tbourgoi/Projet-PeiP-2/programmes/programmes années précédentes.odt

Programmes années précédentes

Programmes DI38 Yoyotte Carla Pierre Rocheteau

1. Programme permettant au robot d'avancer :

/* Programme Avance*/ /* Faire fonctionner les moteurs */

#include<Servo.h>

#define SERVO_GAUCHE_PIN 10

#define SERVO_DROIT_PIN 11

#define T1_1 1700//durée T1 sens horaire

#define T1_2 1300//durée T1 sens trigonométrique

#define T1_3 1500//durée T1 sens arret

Servo Servo_droit;

Servo Servo_gauche;

void Avance (int duree_deplacement)

{

Servo_droit.writeMicroseconds(T1_2);

Servo_gauche.writeMicroseconds(T1_1);

delay(duree_deplacement);

}

void arret(void)

{

Servo_droit.detach();

Servo_gauche.detach();

}

void setup()

{

Serial.begin(9600);

Servo_droit.attach(SERVO_DROIT_PIN);

Servo_gauche.attach(SERVO_GAUCHE_PIN);

Avance(3000);

arret;

}

void loop()

{

}

2. Programme permettant au robot d'éviter les obstacles avec des moustaches :

/* Programme Moustaches*/

#include<Servo.h>

#define LEDMGAUCHE_PIN 8

#define LEDMDROITE_PIN 2

#define SERVO_GAUCHE_PIN 10

#define SERVO_DROIT_PIN 11

#define T1_1 1700//durée T1 sens horaire

#define T1_2 1300//durée T1 sens trigonométrique

#define T1_3 1500/ /durée T1 sens arret

#define Tback 1000

Servo Servo_droit;

Servo Servo_gauche;

int mgauche;

int mdroite;

void Avance (int duree_deplacement)

{

Servo_droit.writeMicroseconds(T1_2);

Servo_gauche.writeMicroseconds(T1_1);

delay(duree_deplacement); }

void Recule(int duree_deplacement)

{

Servo_droit.writeMicroseconds(T1_1);

Servo_gauche.writeMicroseconds(T1_2);

delay(duree_deplacement); }

void Pivote_droit(int duree_deplacement)

{

Servo_droit.writeMicroseconds(T1_1);

Servo_gauche.writeMicroseconds(T1_1);

delay(duree_deplacement);

}

void Pivote_gauche(int duree_deplacement)

{

Servo_droit.writeMicroseconds(T1_2);

Servo_gauche.writeMicroseconds(T1_2);

delay(duree_deplacement);

}

void setup()

{

Serial.begin(9600);

Servo_droit.attach(SERVO_DROIT_PIN);

Servo_gauche.attach(SERVO_GAUCHE_PIN);

pinMode(8,OUTPUT);

pinMode(2,OUTPUT);

}

void loop()

{

mgauche=digitalRead(5);

mdroite=digitalRead(7);

if(mgauche==HIGH && mdroite==HIGH)

{

Avance(50);

}

else if (mgauche==LOW)

{

Recule(Tback);

Pivote_droit(500);

}

else if(mdroite==LOW)

{

Recule(Tback);

Pivote_gauche(500);

}

else if (mgauche==LOW && mdroite==LOW)

{

Recule(Tback);

Pivote_droit(1500);

}

}

3. Programme de détection d’obstacles avec capteurs infrarouge

/* Programme Déplacement_IR*/

#define LED_GAUCHE 8

#define LED_DROITE 7

#include<Servo.h>

#define SERVO_GAUCHE_PIN 13

#define SERVO_DROIT_PIN 12

#define T1_1 1700//durée T1 sens horaire

#define T1_2 1300//durée T1 sens trigonométrique

#define T1_3 1500/ /durée T1 sens arret

#define Tback 1000

Servo Servo_droit;

Servo Servo_gauche;

void Avance (int duree_deplacement)

{

Servo_droit.writeMicroseconds(T1_2);

Servo_gauche.writeMicroseconds(T1_1);

delay(duree_deplacement);

}

void Recule(int duree_deplacement)

{

Servo_droit.writeMicroseconds(T1_1);

Servo_gauche.writeMicroseconds(T1_2);

delay(duree_deplacement);

}

void Pivote_droit(int duree_deplacement)

{

Servo_droit.writeMicroseconds(T1_1);

Servo_gauche.writeMicroseconds(T1_1);

delay(duree_deplacement);

}

void Pivote_gauche(int duree_deplacement)

{

Servo_droit.writeMicroseconds(T1_2);

Servo_gauche.writeMicroseconds(T1_2);

delay(duree_deplacement);

}

int irDetect(int irLedPin, int irReceiverPin, long frequency)

{

tone(irLedPin, frequency, 8); // IRLED 38 kHz for at least 1 ms

delay(1); // Wait 1 ms

int ir = digitalRead(irReceiverPin); // IR receiver -> ir variable

delay(1); // Down time before recheck return ir;

// Return 1 no detect, 0 detect

}

void setup()

{

Serial.begin(9600);

Servo_gauche.attach(13); // Attach left signal to pin 13

Servo_droit.attach(12);

pinMode(10, INPUT);

pinMode(9, OUTPUT); // Left IR LED & Receiver pinMode(3, INPUT);

pinMode(2, OUTPUT); // Right IR LED & Receiver pinMode(8,OUTPUT); pinMode(7,OUTPUT);

}

void loop()

{

int irLeft = irDetect(9, 10, 38000); // Check for object on left

int irRight = irDetect(2, 3, 38000); // Check for object on right

if((irLeft == 0) && (irRight == 0)) // If both sides detect

{

digitalWrite(8, !irLeft); // LED states opposite of IR

digitalWrite(7, !irRight);

Recule(1000);

Pivote_droit(500);

}

else if(irLeft == 0) // If only left side detects

{

digitalWrite(8, !irLeft); // LED states opposite of IR

digitalWrite(7, !irRight);

Recule(Tback);

Pivote_droit(500);

}

else if (irRight == 0) // If only right side detects

{

digitalWrite(8, !irLeft); // LED states opposite of IR

digitalWrite(7, !irRight);

Recule(Tback);

Pivote_gauche(1500);

}

else

{

digitalWrite(8, !irLeft); // LED states opposite of IR

digitalWrite(7, !irRight);

Avance(1000);

}

}

4. Programme de détection du vide

#include<Servo.h>

#define T1_1 1700//durée T1 sens horaire

#define T1_2 1300//durée T1 sens trigonométrique

#define T1_3 1500/ /durée T1 sens arret

#define Tback 1000

Servo Servo_droit;

Servo Servo_gauche;

long randNumber;

int t;

void Avance (int duree_deplacement)

{

Servo_droit.writeMicroseconds(T1_2);

Servo_gauche.writeMicroseconds(T1_1);

delay(duree_deplacement);

}

void Recule(int duree_deplacement)

{

Servo_droit.writeMicroseconds(T1_1);

Servo_gauche.writeMicroseconds(T1_2);

delay(duree_deplacement);

}

void Pivote(int duree_deplacement)

{

randNumber= random(100000);

if (randNumber%2==0)

{ t= T1_1; }

else

{ t=T1_2; }

Servo_droit.writeMicroseconds(t);

Servo_gauche.writeMicroseconds(t);

delay(duree_deplacement);

}

void Pivote_droit(int duree_deplacement)

{

Servo_droit.writeMicroseconds(T1_1);

Servo_gauche.writeMicroseconds(T1_1);

delay(duree_deplacement);

}

void Pivote_gauche(int duree_deplacement)

{

Servo_droit.writeMicroseconds(T1_2);

Servo_gauche.writeMicroseconds(T1_2);

delay(duree_deplacement);

}

int irDetect(int irLedPin, int irReceiverPin, long frequency)

{

tone(irLedPin, frequency, 8); // IRLED 38 kHz for at least 1 ms

delay(1); // Wait 1 ms

int ir = digitalRead(irReceiverPin); // IR receiver -> ir variable

delay(1); // Down time before recheck

return ir; // Return 1 no detect, 0 detect }

void react_vers_droite()

{

Servo_droit.writeMicroseconds(T1_1);

Servo_gauche.writeMicroseconds(T1_1);

delay(800);

}

void react_vers_gauche()

{

Servo_droit.writeMicroseconds(T1_2);

Servo_gauche.writeMicroseconds(T1_2);

delay(800);

}

void setup()

{

Serial.begin(9600);

Servo_gauche.attach(13); // Attach left signal to pin 13

Servo_droit.attach(12);

pinMode(10, INPUT);

pinMode(9, OUTPUT);

pinMode(8,OUTPUT); // Left IR LED & Receiver

pinMode(3, INPUT);

pinMode(2, OUTPUT);

pinMode(4,OUTPUT); // Right IR LED & Receiver

pinMode(6,INPUT); pinMode(5,OUTPUT);

pinMode(7,OUTPUT); // Robot

attachInterrupt (9,react_vers_droite,FALLING); // Interruption détecteur vide gauche attachInterrupt (2,react_vers_gauche,FALLING); // Iterruption detecteur vide droit

}

void loop()

{

int irSol_G = irDetect(9, 10, 38000); // Check for object on left

int irSol_D = irDetect(2, 10, 38000); // Check for object on right

int irRobot = irDetect(5, 6, 38000); // Check for object in front

int irD = irDetect(2, 3, 38000); // Detection robot

if((irSol_D == 1) || (irSol_G == 1)) // Si le robot est dans le vide, pas d'obstacle

{

digitalWrite(4, irSol_D); // LED states opposite of IR

digitalWrite(8, irSol_G);

digitalWrite(7, !irRobot);

Recule(1000);

Pivote(500);

}

else if(irSol_D == 1) // If only left side detects

{

digitalWrite(4, irSol_D); // LED states opposite of IR

digitalWrite(8, irSol_G);

digitalWrite(7, !irRobot);

Recule(Tback);

Pivote_gauche(400);

}

else if (irSol_G == 1) // If only right side detect

{

digitalWrite(4, irSol_D); // LED states opposite of IR

digitalWrite(8, irSol_G);

digitalWrite(7, !irRobot);

Recule(Tback);

Pivote_droit(400);

}

else if (irRobot==0)

{

digitalWrite(4, irSol_D); // LED states opposite of IR

digitalWrite(8, irSol_G);

digitalWrite(7, !irRobot);

Recule(Tback);

Pivote(500);

}

else

{

digitalWrite(4, irSol_D); // LED states opposite of IR

digitalWrite(8, irSol_G);

digitalWrite(7, !irRobot);

Avance(1000);

}

Voilà le programme utilisé pour la réalisation des toiles :

//prgramme poue les robots peintres // avril 2014 // version 5 //Auteurs : Pierre Gaucher, Nicolas Monmarché, Pierre Rocheteau, Carla Yoyotte #include<Servo.h> #include <Wire.h> // pour le capteur de couleur ADJD-S311 //macro #define MAX3(A,B,C) (((A>=B)&&(A>=C))?(A):((B>=A)&&(B>=C))?(B):((C>=A)&&(C>=B))?(C):;) #define MIN3(A,B,C) (((A<=B)&&(A<=C))?(A):((B<=A)&&(B<=C))?(B):((C<=A)&&(C<=B))?(C):;) //declaration des constantes //capteurs infra rouge #define PIN_IR_EMIT_GAUCHE 9 #define PIN_IR_REC_GAUCHE 10 #define PIN_LED_GAUCHE 8 #define PIN_IR_EMIT_DROITE 3 #define PIN_IR_REC_DROITE 4 #define PIN_LED_DROITE 5 //commande des moteurs #define PIN_SERVO_GAUCHE 13 #define PIN_SERVO_DROIT 12 #define T1_1 1700//durée T1 sens horaire #define T1_2 1300//durée T1 sens trigonométrique #define T1_3 1500 //durée T1 sens arret //détection des couleurs #define SEUIL_COULEUR_MIN 0.05 #define SEUIL_COULEUR_MAX 0.50 #define TAUX_APPRENTISSAGE 0.001

Robotique Collective Artistique 2014

15

#define MAX_RGB 1000 //pour l'étalonnage #define PIN_LED_COULEUR 6 /* capteur de couleur */ // ADJD-S311's I2C address, don't change #define ADJD_S311_ADDRESS 0x74 #define RED 0 #define GREEN 1 #define BLUE 2 #define CLEAR 3 // ADJD-S311's register list #define CTRL 0x00 #define CONFIG 0x01 #define CAP_RED 0x06 #define CAP_GREEN 0x07 #define CAP_BLUE 0x08 #define CAP_CLEAR 0x09 #define INT_RED_LO 0xA #define INT_RED_HI 0xB #define INT_GREEN_LO 0xC #define INT_GREEN_HI 0xD #define INT_BLUE_LO 0xE #define INT_BLUE_HI 0xF #define INT_CLEAR_LO 0x10 #define INT_CLEAR_HI 0x11 #define DATA_RED_LO 0x40 #define DATA_RED_HI 0x41 #define DATA_GREEN_LO 0x42 #define DATA_GREEN_HI 0x43 #define DATA_BLUE_LO 0x44 #define DATA_BLUE_HI 0x45 #define DATA_CLEAR_LO 0x46 #define DATA_CLEAR_HI 0x47 #define OFFSET_RED 0x48 #define OFFSET_GREEN 0x49 #define OFFSET_BLUE 0x4A #define OFFSET_CLEAR 0x4B // Pin definitions: int sdaPin = A4; // serial data, hardwired, can't change int sclPin = A5; // serial clock, hardwired, can't change int ledPin = 2; // LED light source pin, any unused pin will work // initial values for integration time registers unsigned char colorCap[4] = {9, 9, 2, 5}; // values must be between 0 and 15 unsigned int colorInt[4] = {2048, 2048, 2048, 2048}; // max value for these is 4095 unsigned int colorData[4]; // This is where we store the RGB and C data values signed char colorOffset[4]; // Stores RGB and C offset values // variables globales

//servo moteurs Servo Servo_droit; Servo Servo_gauche; unsigned int colorDataInit[4]; //couleurs initiales (apres calibration) float seuil_couleur = SEUIL_COULEUR_MIN; //seuil de reconnaissance de la couleur de calibration byte action = 0; #define ACTION_IMMOBILE 0 #define ACTION_AVANCE 1 #define ACTION_RECULE 2 #define ACTION_TOURNE_DROITE 3 #define ACTION_TOURNE_GAUCHE 4 unsigned long duree_action = 0;

Robotique Collective Artistique 2014

16

unsigned long date_debut_action = 0; /***************************************************/ // Fonctions de mouvement void Avance () { Servo_droit.writeMicroseconds(T1_2); Servo_gauche.writeMicroseconds(T1_1); } void Recule() { Servo_droit.writeMicroseconds(T1_1); Servo_gauche.writeMicroseconds(T1_2); } void Pivote_droit() { Servo_droit.writeMicroseconds(T1_1); Servo_gauche.writeMicroseconds(T1_1); } void Pivote_gauche() { Servo_droit.writeMicroseconds(T1_2); Servo_gauche.writeMicroseconds(T1_2); } void Pivote() { if (random(2)) { Pivote_droit(); } else { Pivote_gauche(); } } /***************************************************/ //fonction pour lire un capteur IR int irDetect(int irLedPin, int irReceiverPin, long frequency) { tone(irLedPin, frequency, 8); // IRLED 38 kHz for at least 1 ms delay(1); // Wait 1 ms int ir = digitalRead(irReceiverPin); // IR receiver -> ir variable delay(10); // Down time before recheck return ir; // Return 1 no detect, 0 detect } /***************************************************/ /* fonction qui calcule la valeur Hue à partir de RGB */ float RGBtoH(int R, int G, int B) { float H = 0.0; float var_R = ( R / float(MAX_RGB) ); float var_G = ( G / float(MAX_RGB) ); float var_B = ( B / float(MAX_RGB) ); float var_Min = var_R; var_Min = var_G<var_Min?var_G:var_Min; var_Min = var_B<var_Min?var_B:var_Min; float var_Max = var_R; var_Max = var_G>var_Max?var_G:var_Max; var_Max = var_B>var_Max?var_B:var_Max; float del_Max = var_Max-var_Min; if ( del_Max == 0 ) H = 0; else { float del_R = ( ( ( var_Max - var_R ) / 6.0 ) + ( del_Max / 2.0 ) ) / del_Max; float del_G = ( ( ( var_Max - var_G ) / 6.0 ) + ( del_Max / 2.0 ) ) / del_Max; float del_B = ( ( ( var_Max - var_B ) / 6.0 ) + ( del_Max / 2.0 ) ) / del_Max; if ( var_R == var_Max ) H = del_B - del_G; else if ( var_G == var_Max ) H = ( 1 / 3.0 ) + del_R - del_B; else if ( var_B == var_Max ) H = ( 2 / 3.0 ) + del_G - del_R; if ( H < 0 ) H += 1; if ( H > 1 ) H -= 1;

Robotique Collective Artistique 2014

17

} return H; } /* fonction qui affiche les composante RGB et H d'une couleur */ void printRGB(int R, int G, int B) { Serial.print("(R,G,B)="); Serial.print(R);Serial.print(","); Serial.print(G);Serial.print(","); Serial.print(B); Serial.print(" Hue = "); Serial.println(RGBtoH(R,G,B)); } /***************************************************/ /* Initialisations */ void setup() { //initialisation de la connexion Serial.begin(9600); //initialisation des servomoteurs Servo_gauche.attach(PIN_SERVO_GAUCHE); Servo_droit.attach(PIN_SERVO_DROIT); //initialisation des led et infrarouge pinMode(PIN_IR_REC_GAUCHE, INPUT); pinMode(PIN_IR_EMIT_GAUCHE, OUTPUT); pinMode(PIN_LED_GAUCHE,OUTPUT); pinMode(PIN_IR_REC_DROITE, INPUT); pinMode(PIN_IR_EMIT_DROITE, OUTPUT); pinMode(PIN_LED_DROITE,OUTPUT); pinMode(PIN_LED_COULEUR, OUTPUT); //capteur de couleur pinMode(ledPin, OUTPUT); // Set the sensor's LED as output digitalWrite(ledPin, HIGH); // Initially turn LED light source on Wire.begin(); delay(1); // Wait for ADJD reset sequence initADJD_S311(); // Initialize the ADJD-S311, sets up cap and int registers /* First we'll see the initial values getRGBC(); // Call this to put new RGB and C values into the colorData array printADJD_S311Values(); // Formats and prints all important registers of ADJD-S311 */ calibrateColor(); // This calibrates R, G, and B int registers calibrateClear(); // This calibrates the C int registers calibrateCapacitors(); // This calibrates the RGB, and C cap registers getRGBC(); // After calibrating, we can get the first RGB and C data readings printADJD_S311Values(); // Formats and prints all important ADJD-S311 registers //Serial.println("\nAll values should be under 1000. If they're not, try calibrating again, or decreasing the ambient brightness somehow. "); //on cherche la valeur max des composante RGB int max_rgb=colorData[0]; if (colorData[1]>max_rgb) { max_rgb = colorData[1]; } if (colorData[2]>max_rgb) { max_rgb = colorData[2]; } //tant que le max est >=1000 on recalibre le capteur while (max_rgb >= MAX_RGB) { // If c is pressed, calibrate int and cap registers, then get a reading and print it Serial.println("\nCalibrating...\n");

Robotique Collective Artistique 2014

18

calibrateColor(); calibrateClear(); calibrateCapacitors(); getRGBC(); printADJD_S311Values(); max_rgb=colorData[0]; if (colorData[1]>max_rgb) { max_rgb = colorData[1]; } if (colorData[2]>max_rgb) { max_rgb = colorData[2]; } } /* on memorise la couleur lue à la derniere calibration */ for (int i=0; i<4; i++) { colorDataInit[i] = colorData[i]; } Serial.print("colorDataInit : "); printRGB(colorDataInit[0],colorDataInit[1],colorDataInit[2]); /*petite séquence de clignotement sur les led pour dire que le setup est terminé */ for (int i=0 ; i<5;i++) { digitalWrite(PIN_LED_GAUCHE, HIGH); digitalWrite(PIN_LED_DROITE, LOW); digitalWrite(PIN_LED_COULEUR,LOW); delay(100); digitalWrite(PIN_LED_GAUCHE, LOW); digitalWrite(PIN_LED_DROITE, HIGH); digitalWrite(PIN_LED_COULEUR,LOW); delay(100); digitalWrite(PIN_LED_GAUCHE, LOW); digitalWrite(PIN_LED_DROITE, LOW); digitalWrite(PIN_LED_COULEUR,HIGH); delay(100); } digitalWrite(PIN_LED_GAUCHE, LOW); digitalWrite(PIN_LED_DROITE, LOW); digitalWrite(PIN_LED_COULEUR,LOW); } /***************************************************/ /* boucle principale */ void loop() { /*lecture des capteurs */ unsigned long time = millis(); /* recherche obstacle */ int irSol_D = irDetect(PIN_IR_EMIT_DROITE, PIN_IR_REC_DROITE, 38000); // Check for object on right int irSol_G = irDetect(PIN_IR_EMIT_GAUCHE, PIN_IR_REC_GAUCHE, 38000); // Check for object on left Serial.print("IR gauche = "); Serial.println(irSol_G); Serial.print("IR droite = "); Serial.println(irSol_D); digitalWrite(PIN_LED_GAUCHE, !irSol_G); digitalWrite(PIN_LED_DROITE, !irSol_D); /* couleur */ digitalWrite(PIN_LED_COULEUR, LOW); getRGBC(); //calcul de la difference de couleur

Robotique Collective Artistique 2014

19

float valeur = 0.0; float diff; //vrai si une couleur differente de la couleur d'initialisation a été reperee boolean trace_presente = false; diff = RGBtoH(colorData[0],colorData[1],colorData[2]) - RGBtoH(colorDataInit[0],colorDataInit[1],colorDataInit[2]); valeur = abs(diff); printRGB(colorDataInit[0],colorDataInit[1],colorDataInit[2]); printRGB(colorData[0],colorData[1],colorData[2]); Serial.print("Ecart couleur = "); Serial.println(valeur); Serial.print("Seuil detection = "); Serial.println(seuil_couleur); /* apprentissage de la valeur de seuil pour la detection d'une couleur */ trace_presente = (valeur>seuil_couleur); if (trace_presente) { seuil_couleur *= (1.0+TAUX_APPRENTISSAGE); } else { seuil_couleur *= (1.0-TAUX_APPRENTISSAGE); } if (seuil_couleur < SEUIL_COULEUR_MIN ) { seuil_couleur = SEUIL_COULEUR_MIN; } if ( seuil_couleur > SEUIL_COULEUR_MAX ) { seuil_couleur = SEUIL_COULEUR_MAX; } /* decisions */ if((irSol_D == 0) && (irSol_G == 0)) { //ir gauche ET ir droit = obstacle Recule(); delay(300+random(300)); Pivote(); delay(200+random(400)); } else if (irSol_D == 0) { //ir droit = obstacle Recule(); delay(200+random(200)); Pivote_gauche(); delay(200+random(400)); } else if (irSol_G == 0) { //ir gauche = obstacle Recule(); delay(200+random(200)); Pivote_droit(); delay(200+random(400)); } else if (trace_presente) { digitalWrite(PIN_LED_COULEUR,HIGH); // Recule(); // delay (200); Pivote(); delay(400+random(600)); } else { Avance(); } }

/***************************************************/ // fonctions pour le capteur de couleur ADJD-S311 /***************************************************/ /* ADJD-S311 Color Sensor Breakout Example Code by: Jim Lindblom Updated by: T. Klopfenstein SparkFun Electronics date: 8/9/11

Robotique Collective Artistique 2014

20

ADJD-S311 Breakout ------------- Arduino ---------------------------------------- LED ---------------------------D2 3.3V -------------------------3.3V GND -------------------------- GND SCL -------------------------- A5 SDA -------------------------- A4 GND -------------------------- GND SLP --------------------- Not connected CLK --------------------- Not connected */ /* printADJD_S311Values() reads, formats, and prints all important registers of the ADJD-S311. It doesn't perform any measurements, so you'll need to call getRGBC() to print new values. */ void printADJD_S311Values() { Serial.println("\t\t Red \t Green \t Blue \t Clear"); Serial.print("Data: \t\t "); for (int i=0; i<4; i++) { Serial.print(colorData[i]); Serial.print("\t "); } Serial.println(); for (int i=0; i<4; i++) { Serial.print(colorData[i]); Serial.print("\t "); } Serial.println(); Serial.print("Caps: \t\t "); for (int i=0; i<4; i++) { Serial.print(readRegister(CAP_RED+i), DEC); Serial.print("\t "); } Serial.println(); Serial.print("Int: \t\t "); for (int i=0; i<4; i++) { Serial.print(readRegisterInt(INT_RED_LO+(i*2)), DEC); Serial.print("\t "); } Serial.println(); Serial.print("Offset: \t "); for (int i=0; i<4; i++) { Serial.print((signed char) readRegister(OFFSET_RED+i), DEC); Serial.print("\t "); } Serial.println(); }

/* initADJD_S311() - This function initializes the ADJD-S311 and its capacitor and integration registers The vaules for those registers are defined near the top of the code. the colorCap[] array defines all capacitor values, colorInt[] defines

Robotique Collective Artistique 2014

21

all integration values. */ void initADJD_S311() { /*sensor gain registers, CAP_... to select number of capacitors. value must be <= 15 */ writeRegister(colorCap[RED] & 0xF, CAP_RED); writeRegister(colorCap[GREEN] & 0xF, CAP_GREEN); writeRegister(colorCap[BLUE] & 0xF, CAP_BLUE); writeRegister(colorCap[CLEAR] & 0xF, CAP_CLEAR); /* Write sensor gain registers INT_... to select integration time value must be <= 4096 */ writeRegister((unsigned char)colorInt[RED], INT_RED_LO); writeRegister((unsigned char)((colorInt[RED] & 0x1FFF) >> 8), INT_RED_HI); writeRegister((unsigned char)colorInt[BLUE], INT_BLUE_LO); writeRegister((unsigned char)((colorInt[BLUE] & 0x1FFF) >> 8), INT_BLUE_HI); writeRegister((unsigned char)colorInt[GREEN], INT_GREEN_LO); writeRegister((unsigned char)((colorInt[GREEN] & 0x1FFF) >> 8), INT_GREEN_HI); writeRegister((unsigned char)colorInt[CLEAR], INT_CLEAR_LO); writeRegister((unsigned char)((colorInt[CLEAR] & 0x1FFF) >> 8), INT_CLEAR_HI); } /* calibrateClear() - This function calibrates the clear integration registers of the ADJD-S311. */ int calibrateClear() { int gainFound = 0; int upperBox=4096; int lowerBox = 0; int half; while (!gainFound) { half = ((upperBox-lowerBox)/2)+lowerBox; //no further halfing possbile if (half==lowerBox) gainFound=1; else { writeInt(INT_CLEAR_LO, half); performMeasurement(); int halfValue = readRegisterInt(DATA_CLEAR_LO); if (halfValue>1000) upperBox=half; else if (halfValue<1000) lowerBox=half; else gainFound=1; } } return half; } /* calibrateColor() - This function clalibrates the RG and B integration registers. */ int calibrateColor() { int gainFound = 0;

Robotique Collective Artistique 2014

22

int upperBox=4096; int lowerBox = 0; int half; while (!gainFound) { half = ((upperBox-lowerBox)/2)+lowerBox; //no further halfing possbile if (half==lowerBox) { gainFound=1; } else { writeInt(INT_RED_LO, half); writeInt(INT_GREEN_LO, half); writeInt(INT_BLUE_LO, half); performMeasurement(); int halfValue = 0; halfValue=max(halfValue, readRegisterInt(DATA_RED_LO)); halfValue=max(halfValue, readRegisterInt(DATA_GREEN_LO)); halfValue=max(halfValue, readRegisterInt(DATA_BLUE_LO)); if (halfValue>1000) { upperBox=half; } else if (halfValue<1000) { lowerBox=half; } else { gainFound=1; } } } return half; } /* calibrateCapacitors() - This function calibrates each of the RGB and C capacitor registers. */ void calibrateCapacitors() { int calibrationRed = 0; int calibrationBlue = 0; int calibrationGreen = 0; int calibrated = 0; //need to store detect better calibration int oldDiff = 5000; while (!calibrated) { // sensor gain setting (Avago app note 5330) // CAPs are 4bit (higher value will result in lower output) writeRegister(calibrationRed, CAP_RED); writeRegister(calibrationGreen, CAP_GREEN); writeRegister(calibrationBlue, CAP_BLUE); // int colorGain = _calibrateColorGain(); int colorGain = readRegisterInt(INT_RED_LO); writeInt(INT_RED_LO, colorGain); writeInt(INT_GREEN_LO, colorGain); writeInt(INT_BLUE_LO, colorGain);

int maxRead = 0; int minRead = 4096;

Robotique Collective Artistique 2014

23

int red = 0; int green = 0; int blue = 0; for (int i=0; i<4 ;i ++) { performMeasurement(); red += readRegisterInt(DATA_RED_LO); green += readRegisterInt(DATA_GREEN_LO); blue += readRegisterInt(DATA_BLUE_LO); } red /= 4; green /= 4; blue /= 4; maxRead = max(maxRead, red); maxRead = max(maxRead, green); maxRead = max(maxRead, blue); minRead = min(minRead, red); minRead = min(minRead, green); minRead = min(minRead, blue); int diff = maxRead - minRead; if (oldDiff != diff) { if ((maxRead==red) && (calibrationRed<15)) calibrationRed++; else if ((maxRead == green) && (calibrationGreen<15)) calibrationGreen++; else if ((maxRead == blue) && (calibrationBlue<15)) calibrationBlue++; } else calibrated = 1; oldDiff=diff; int rCal = calibrationRed; int gCal = calibrationGreen; int bCal = calibrationBlue; } } /* writeInt() - This function writes a 12-bit value to the LO and HI integration registers */ void writeInt(int address, int gain) { if (gain < 4096) { byte msb = gain >> 8; byte lsb = gain; writeRegister(lsb, address); writeRegister(msb, address+1); } } /* performMeasurement() - This must be called before reading any of the data registers. This commands the ADJD-S311 to perform a measurement, and store the data into the data registers.*/ void performMeasurement() { writeRegister(0x01, 0x00); // start sensing while(readRegister(0x00) != 0) ; // waiting for a result }

Robotique Collective Artistique 2014

24

/* getRGBC() - This function reads all of the ADJD-S311's data registers and stores them into colorData[]. To get the most up-to-date data make sure you call performMeasurement() before calling this function.*/ void getRGBC() { performMeasurement(); colorData[RED] = readRegisterInt(DATA_RED_LO); colorData[GREEN] = readRegisterInt(DATA_GREEN_LO); colorData[BLUE] = readRegisterInt(DATA_BLUE_LO); colorData[CLEAR] = readRegisterInt(DATA_CLEAR_LO); } /* getOffset() - This function performs the offset reading and stores the offset data into the colorOffset[] array. You can turn on data trimming by uncommenting out the writing 0x01 to 0x01 code. */ void getOffset() { digitalWrite(ledPin, LOW); // turn LED off delay(10); // wait a tic writeRegister(0x02, 0x00); // start sensing while(readRegister(0x00) != 0) ; // waiting for a result //writeRegister(0x01, 0x01); // set trim //delay(100); for (int i=0; i<4; i++) colorOffset[i] = (signed char) readRegister(OFFSET_RED+i); digitalWrite(ledPin, HIGH); } /* I2C functions...*/ // Write a byte of data to a specific ADJD-S311 address void writeRegister(unsigned char data, unsigned char address) { Wire.beginTransmission(ADJD_S311_ADDRESS); Wire.write(address); Wire.write(data); Wire.endTransmission(); } // read a byte of data from ADJD-S311 address unsigned char readRegister(unsigned char address) { unsigned char data; Wire.beginTransmission(ADJD_S311_ADDRESS); Wire.write(address); Wire.endTransmission(); Wire.requestFrom(ADJD_S311_ADDRESS, 1); while (!Wire.available()) ; // wait till we can get data return Wire.read(); } // Write two bytes of data to ADJD-S311 address and addres+1 int readRegisterInt(unsigned char address) { return readRegister(address) + (readRegister(address+1)<<8); }
