tbourgoi/Projet-PeiP-2/programmes/programmes.odt

Trajectoire gauche correcte

#include <Servo.h>

Servo Servo_droit;

Servo Servo_gauche;

#define MOTEUR_G 12

#define MOTEUR_D 13

#define T1_1 1700//durée T1 sens horaire

#define T1_2 1300//durée T1 sens trigonométrique

#define T1_3 1500//durée T1 sens arret

void setup() {

// put your setup code here, to run once:

Serial.begin(9600);

Servo_droit.attach(MOTEUR_D);

Servo_gauche.attach(MOTEUR_G);

//pour robots bleu et rose

Avancer(2000);

Pivote_gauche(1250);

Avancer(1000);

Pivote_gauche(1250);

Avancer(2000);

Pivote_gauche(1200);

Avancer(1500);

arret();

//pour robots rouge et jaune

/*

//pour robots bleu et rose

Avancer(2000);

Pivote_gauche(1000);

Avancer(1000);

Pivote_gauche(1000);

Avancer(2000);

Pivote_gauche(1000);

Avancer(1500);

arret();

*/

}

void loop()

{

}

void Avancer (int duree_deplacement)

{

Servo_droit.writeMicroseconds(T1_2);

Servo_gauche.writeMicroseconds(T1_1);

delay (duree_deplacement);

}

void Reculer(int duree_deplacement)

{

Servo_droit.writeMicroseconds(T1_1);

Servo_gauche.writeMicroseconds(T1_2);

delay (duree_deplacement);

}

void arret(void)

{

Servo_droit.detach();

Servo_gauche.detach();

}

/* les fonction pivote_gauche et

pivote_droit font tounrer le robot à 90°

pour 1250 à gauche et 1050 à droite

*/

void Pivote_droite(int duree_deplacement)

{

Servo_droit.writeMicroseconds(T1_3);

Servo_gauche.writeMicroseconds(T1_1);

delay(duree_deplacement);

}

void Pivote_gauche(int duree_deplacement)

{

Servo_droit.writeMicroseconds(T1_2);

Servo_gauche.writeMicroseconds(T1_3);

delay(duree_deplacement);

}

Trajectoire droite correcte

#include <Servo.h>

Servo Servo_droit;

Servo Servo_gauche;

#define MOTEUR_G 12

#define MOTEUR_D 13

#define T1_1 1700//durée T1 sens horaire

#define T1_2 1300//durée T1 sens trigonométrique

#define T1_3 1500//durée T1 sens arret

void setup() {

// put your setup code here, to run once:

Serial.begin(9600);

Servo_droit.attach(MOTEUR_D);

Servo_gauche.attach(MOTEUR_G);

//pour robots bleu et rose

Avancer(2000);

Pivote_droite(1000);

Avancer(1000);

Pivote_droite(1000);

Avancer(2000);

Pivote_droite(1000);

Avancer(1500);

arret();

//pour robots rouge et jaune

/*Avancer(2000);

Pivote_droite(1050);

Avancer(1000);

Pivote_droite(1050);

Avancer(2000);

Pivote_droite(1050);

Avancer(1500);

arret();

*/

}

void loop()

{

}

void Avancer (int duree_deplacement)

{

Servo_droit.writeMicroseconds(T1_2);

Servo_gauche.writeMicroseconds(T1_1);

delay (duree_deplacement);

}

void Reculer(int duree_deplacement)

{

Servo_droit.writeMicroseconds(T1_1);

Servo_gauche.writeMicroseconds(T1_2);

delay (duree_deplacement);

}

void arret(void)

{

Servo_droit.writeMicroseconds(T1_3);

Servo_gauche.writeMicroseconds(T1_3);

}

void Pivote_droite(int duree_deplacement)

{

Servo_droit.writeMicroseconds(T1_3);

Servo_gauche.writeMicroseconds(T1_1);

delay(duree_deplacement);

}

void Pivote_gauche(int duree_deplacement)

{

Servo_droit.writeMicroseconds(T1_2);

Servo_gauche.writeMicroseconds(T1_3);

delay(duree_deplacement);

}

Trajectoire droite bizarre car pour avancer à gauche 1700 pas 1300 (ça c’est pour à droite)

#include <Servo.h>

Servo Servo_droit;

Servo Servo_gauche;

#define MOTEUR_G 12

#define MOTEUR_D 13

#define T1_1 1700//durée T1 sens horaire

#define T1_2 1300//durée T1 sens trigonométrique

#define T1_3 1500//durée T1 sens arret

void setup() {

// put your setup code here, to run once:

Serial.begin(9600);

Servo_droit.attach(MOTEUR_D);

Servo_gauche.attach(MOTEUR_G);

Avancer(2000);

Pivote_droit(1250);

Avancer(1000);

Pivote_droit(1250);

Avancer(2000);

Pivote_droit(1250);

Avancer(1500);

arret();

}

void loop()

{

}

void Avancer (int duree_deplacement)

{

Servo_droit.writeMicroseconds(T1_2);

Servo_gauche.writeMicroseconds(T1_1);

delay (duree_deplacement);

}

void Reculer(int duree_deplacement)

{

Servo_droit.writeMicroseconds(T1_1);

Servo_gauche.writeMicroseconds(T1_2);

delay (duree_deplacement);

}

void arret(void)

{

// Servo_droit.detach();

// Servo_gauche.detach();

Servo_droit.writeMicroseconds(T1_3);

Servo_gauche.writeMicroseconds(T1_3);

}

void Pivote_droit(int duree_deplacement)

{

Servo_droit.writeMicroseconds(T1_3);

Servo_gauche.writeMicroseconds(T1_2);

delay(duree_deplacement);

}

void Pivote_gauche(int duree_deplacement)

{

Servo_droit.writeMicroseconds(T1_2);

Servo_gauche.writeMicroseconds(T1_3);

delay(duree_deplacement);

}

→ tester avec 1700 1700 pour à droite et 1300 1300 pour à gauche

Trajectoire circulaire à gauche et à droite

#include <Servo.h>

Servo Servo_droit;

Servo Servo_gauche;

#define MOTEUR_G 12

#define MOTEUR_D 13

#define T1_1 1700//durée T1 sens horaire

#define T1_2 1300//durée T1 sens trigonométrique

#define T1_3 1500//durée T1 sens arret

void setup() {

// put your setup code here, to run once:

Serial.begin(9600);

Servo_droit.attach(MOTEUR_D);

Servo_gauche.attach(MOTEUR_G);

/*

// Pour le robot bleu et le rose

Avancer(2000);

Pivote_gauche(4750); //tour complet pour un cercle

Avancer(2000);

Pivote_droite(4450); //tour complet pour un cercle

arret();

*/

// Pour le robot rouge et le jaune

Avancer(2000);

Pivote_gauche(4000); //tour complet pour un cercle

Avancer(2000);

Pivote_droite(4100); //tour complet pour un cercle

arret();

}

void loop() {

// put your main code here, to run repeatedly:

}

void Avancer (int duree_deplacement)

{

Servo_droit.writeMicroseconds(T1_2);

Servo_gauche.writeMicroseconds(T1_1);

delay (duree_deplacement);

}

void Reculer(int duree_deplacement)

{

Servo_droit.writeMicroseconds(T1_1);

Servo_gauche.writeMicroseconds(T1_2);

delay (duree_deplacement);

}

void arret(void)

{

Servo_droit.writeMicroseconds(T1_3);

Servo_gauche.writeMicroseconds(T1_3);

}

/* mauvaise fonction avec la meme roue bloqué que pour pivote gauche et l'autre qui recule

void Pivote_droite(int duree_deplacement)

{

Servo_droit.writeMicroseconds(T1_1);

Servo_gauche.writeMicroseconds(T1_3);

delay(duree_deplacement);

}

*/

void Pivote_droite(int duree_deplacement)

{

Servo_droit.writeMicroseconds(T1_3);

Servo_gauche.writeMicroseconds(T1_1);

delay(duree_deplacement);

}

void Pivote_gauche(int duree_deplacement)

{

Servo_droit.writeMicroseconds(T1_2);

Servo_gauche.writeMicroseconds(T1_3);

delay(duree_deplacement);

}

Détecteur infrarouge

//#include <RobotIRremote.h>

//#include <RobotIRremoteInt.h>

//#include <RobotIRremoteTools.h>

#include <Servo.h>

#define MOTEUR_G 12

#define MOTEUR_D 13

#define T1_1 1700//durée T1 sens horaire

#define T1_2 1300//durée T1 sens trigonométrique

#define T1_3 1500//durée T1 sens arret

#define IR_DROIT 1

#define IR_GAUCHE 0

#define LEDD_PIN_G 11

#define LEDD_PIN_D 10

#define DISTANCE 10

Servo Servo_droit;

Servo Servo_gauche;

void setup() {

// put your setup code here, to run once:

analogReference(DEFAULT);

Serial.begin(9660);

Servo_droit.attach(MOTEUR_D);

Servo_gauche.attach(MOTEUR_G);

pinMode(IR_DROIT, INPUT);

pinMode(IR_GAUCHE, INPUT);

pinMode(LEDD_PIN_G, OUTPUT);

digitalWrite(LEDD_PIN_G, LOW);

pinMode(LEDD_PIN_D, OUTPUT);

digitalWrite(LEDD_PIN_D, LOW);

}

void loop() {

// put your main code here, to run repeatedly:

int infra_droit=analogRead(IR_DROIT);

int volt_droit=map(infra_droit, 0, 1023, 0, 5000);

int cm_droit=(21.61/(volt_droit-0.1696))*1000;

Serial.println(cm_droit);

int infra_gauche=analogRead(IR_GAUCHE);

int volt_gauche=map(infra_gauche, 0, 1023, 0, 5000);

int cm_gauche=(21.61/(volt_gauche-0.1696))*1000;

Serial.println(cm_gauche);

if(cm_droit<=DISTANCE)

{

digitalWrite(LEDD_PIN_D, HIGH);

Reculer(300);

digitalWrite(LEDD_PIN_D, LOW);

Pivote_gauche(1000);

}

else

{

if(cm_gauche<=DISTANCE)

{

digitalWrite(LEDD_PIN_G, HIGH);

Reculer(300);

digitalWrite(LEDD_PIN_G, LOW);

Pivote_droit(1000);

}

else {

Avancer(1000);

}

}

}

void delai_avec_ir(int duree)

{

/*Fonction similaire à la fonction delay, mais qui continue de détetcter les objets*/

int t_0 = millis();

while(millis()-t_0 < duree)

{

// detection_infrarouge(6);

}

}

void Avancer (int duree_deplacement)

{

Servo_droit.writeMicroseconds(T1_2);

Servo_gauche.writeMicroseconds(T1_1);

delay (duree_deplacement);

}

void Reculer(int duree_deplacement)

{

Servo_droit.writeMicroseconds(T1_1);

Servo_gauche.writeMicroseconds(T1_2);

delay (duree_deplacement);

}

void arret(void)

{

// Servo_droit.detach();

// Servo_gauche.detach();

Servo_droit.writeMicroseconds(T1_3);

Servo_gauche.writeMicroseconds(T1_3);

}

void Pivote_droit(int duree_deplacement)

{

Servo_droit.writeMicroseconds(T1_3);

Servo_gauche.writeMicroseconds(T1_1);

delay(duree_deplacement);

}

void Pivote_gauche(int duree_deplacement)

{

Servo_droit.writeMicroseconds(T1_2);

Servo_gauche.writeMicroseconds(T1_3);

delay(duree_deplacement);

}
