tbourgoi/Projet-PeiP-2/catia c'est bien.jpeg

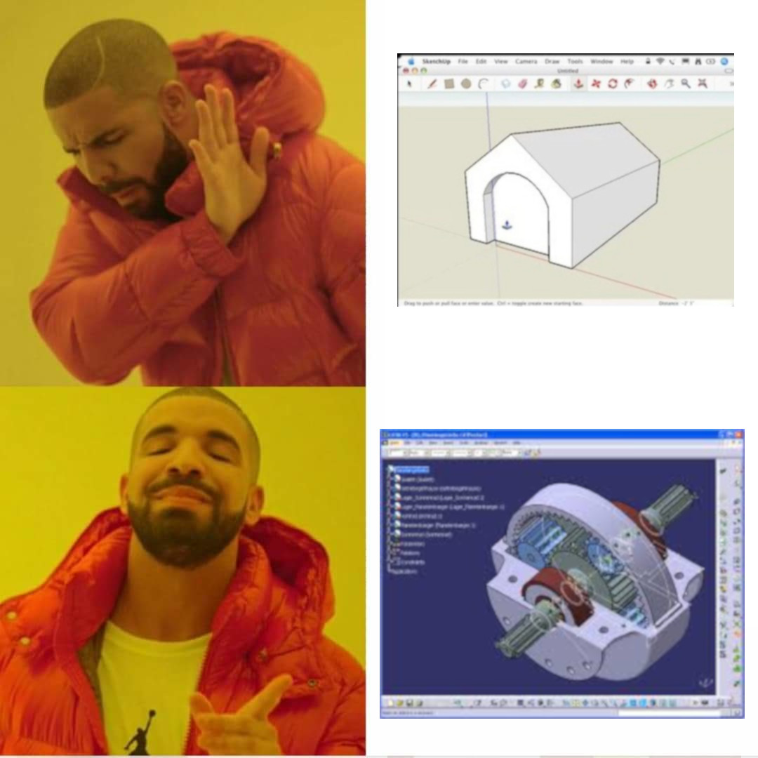
catia c'est bien.jpeg
