tbourgoi/Projet-PeiP-2/feufeufeu.png

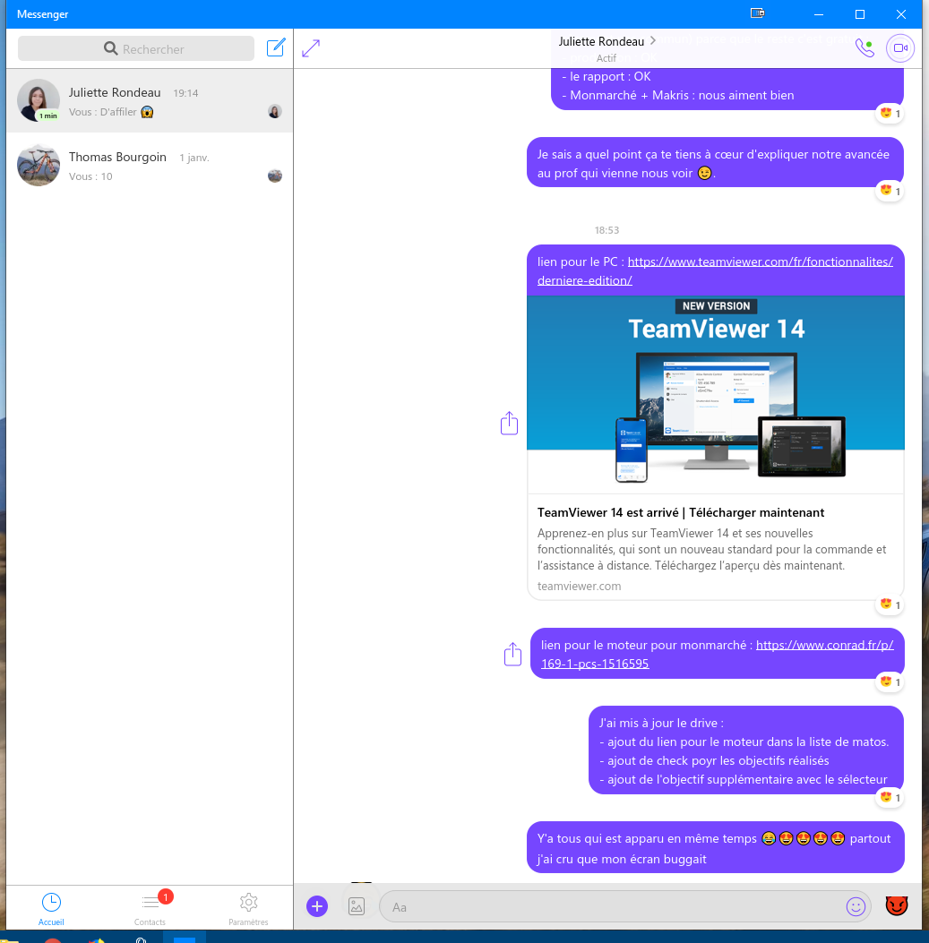
feufeufeu.png
