tbourgoi/Projet-PeiP-2/photos/cartes.JPG

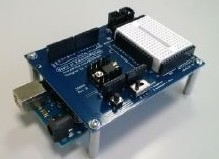
photos/cartes.JPG
