tbourgoi/Projet-PeiP-2/photos/programme_ir2_reduit.JPG

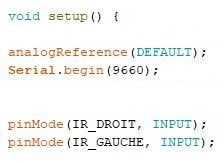
photos/programme_ir2_reduit.JPG
