tbourgoi/Projet-PeiP-2/photos/received_391025411745889.jpeg

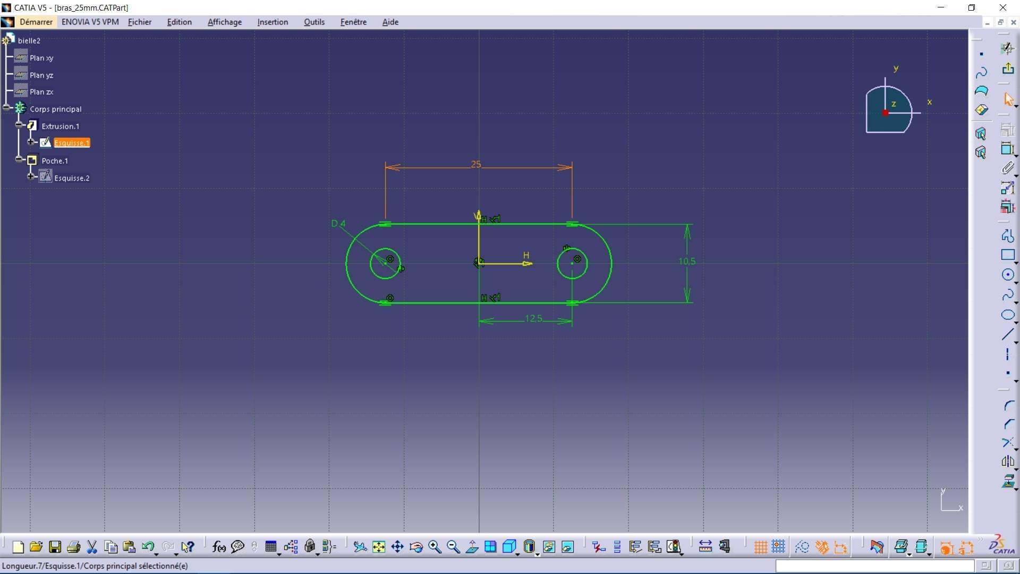
photos/received_391025411745889.jpeg
