tbourgoi/Projet-PeiP-2/photos/received_817803591887172.jpeg

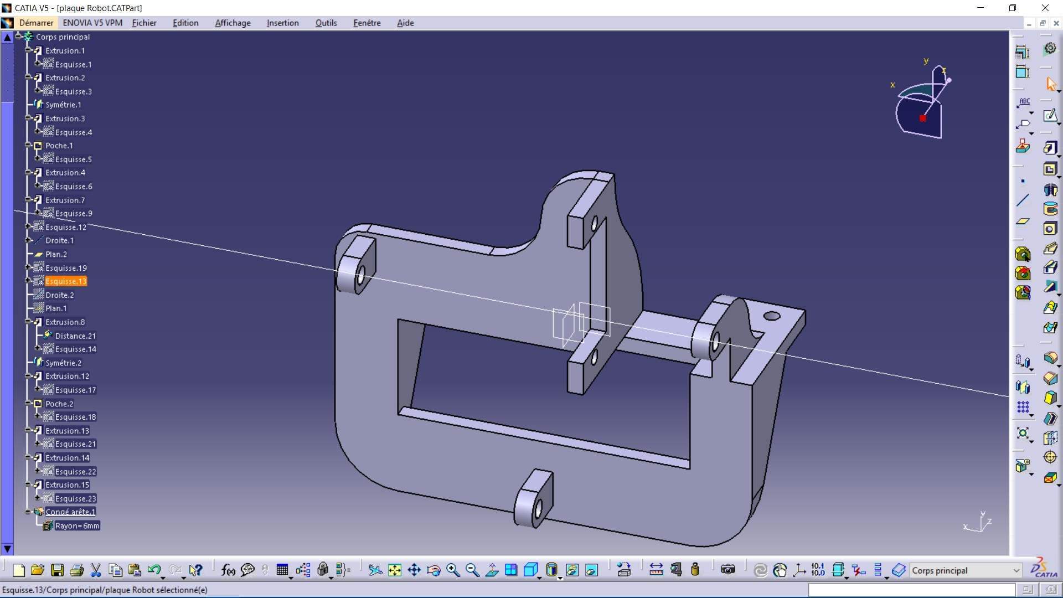
photos/received_817803591887172.jpeg
