tbourgoi/Projet-PeiP-2/photos/received_2340782366137046.jpeg

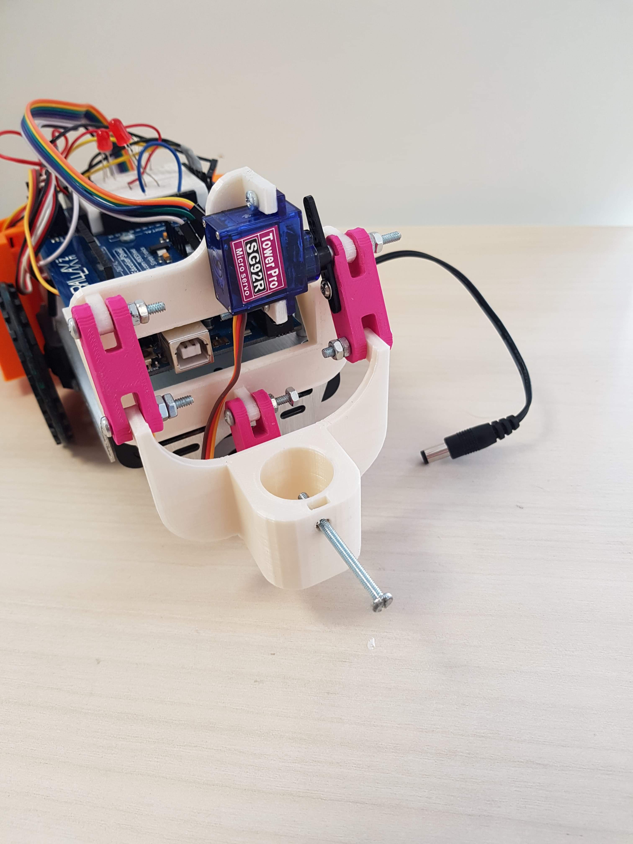
photos/received_2340782366137046.jpeg
