tbourgoi/Projet-PeiP-2/photos/screen_lve_crayon_entier.jpg

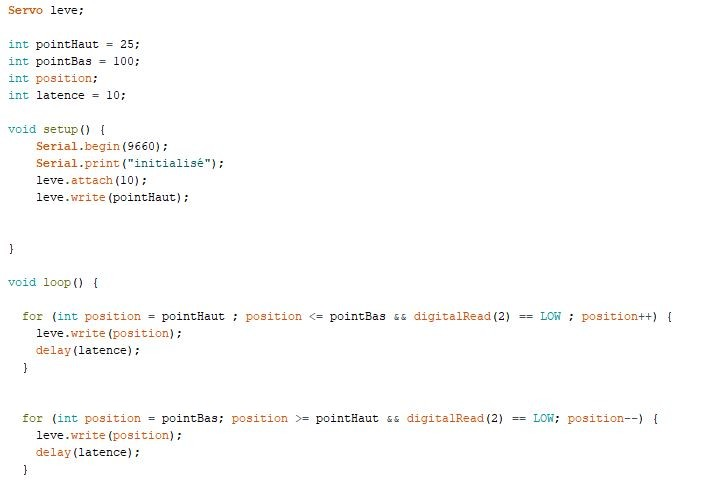
photos/screen_lve_crayon_entier.jpg
