tbourgoi/Projet-PeiP-2/photos/servomoteur sur le mecanisme.jpeg

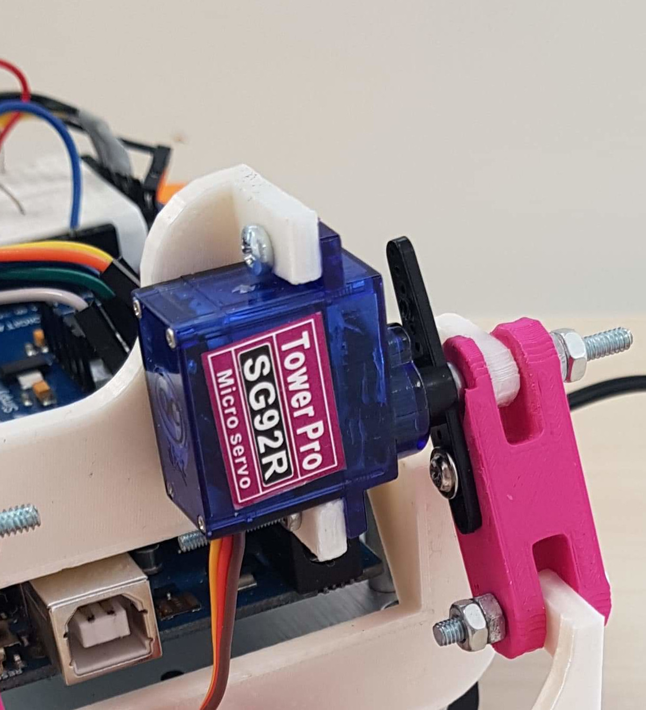
photos/servomoteur sur le mecanisme.jpeg
