tbourgoi/Projet-PeiP-2/pièces 3D/Catia/anciennes pièces/Assemblage.stp

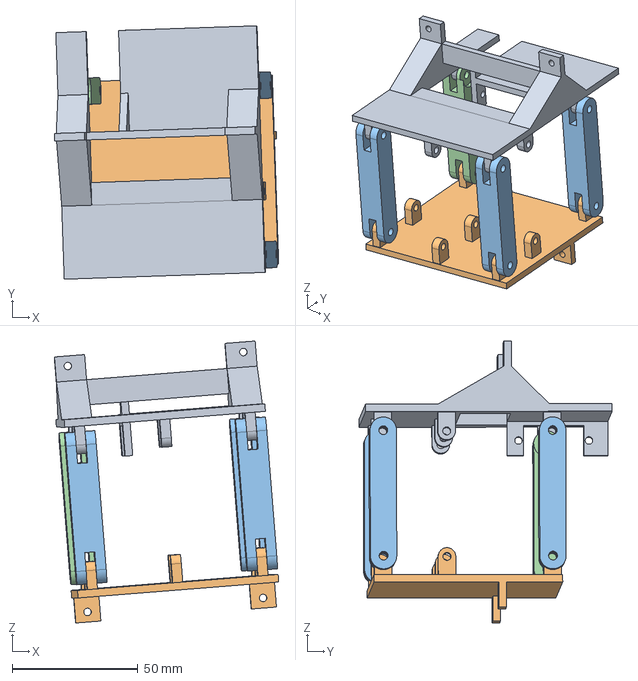
[picture p41: CAD file, 2019-02-01]
pièces 3D/Catia/anciennes pièces/Assemblage.stp
89.2 x 100.7 x 112.0 mm
