tbourgoi/Projet-PeiP-2/pièces 3D/Catia/anciennes pièces/Asemblage1.1.stp

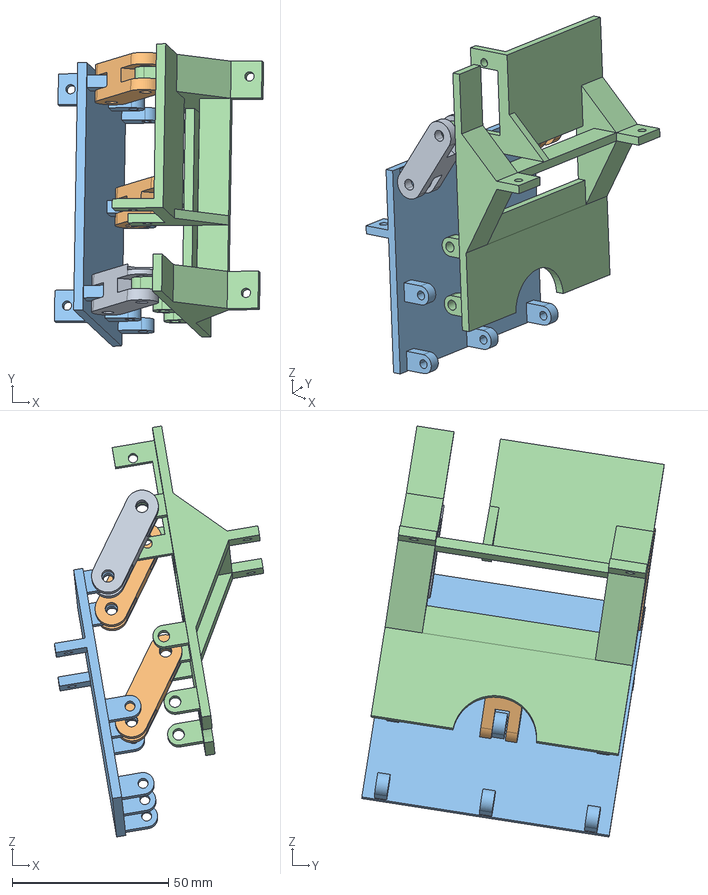
[picture p42: CAD file, 2019-02-19]
pièces 3D/Catia/anciennes pièces/Asemblage1.1.stp
66.9 x 96.7 x 131.3 mm
