tbourgoi/Projet-PeiP-2/pièces 3D/Catia/plaque côté Robot.stl

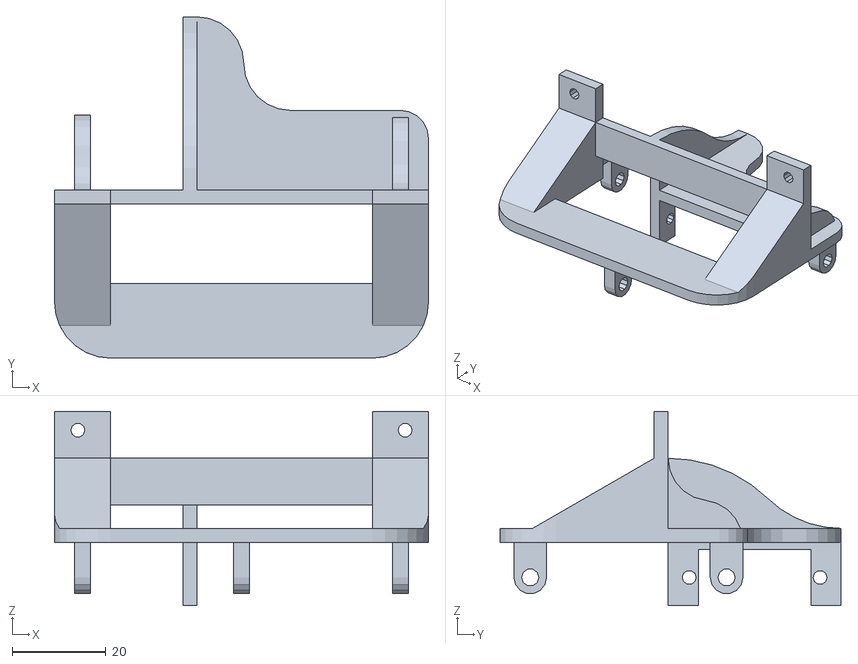
[picture p43: CAD file, 2019-03-12]
pièces 3D/Catia/plaque côté Robot.stl
80.0 x 73.0 x 41.5
