tbourgoi/Projet-PeiP-2/pièces 3D/Catia/porte crayon mobile.stl

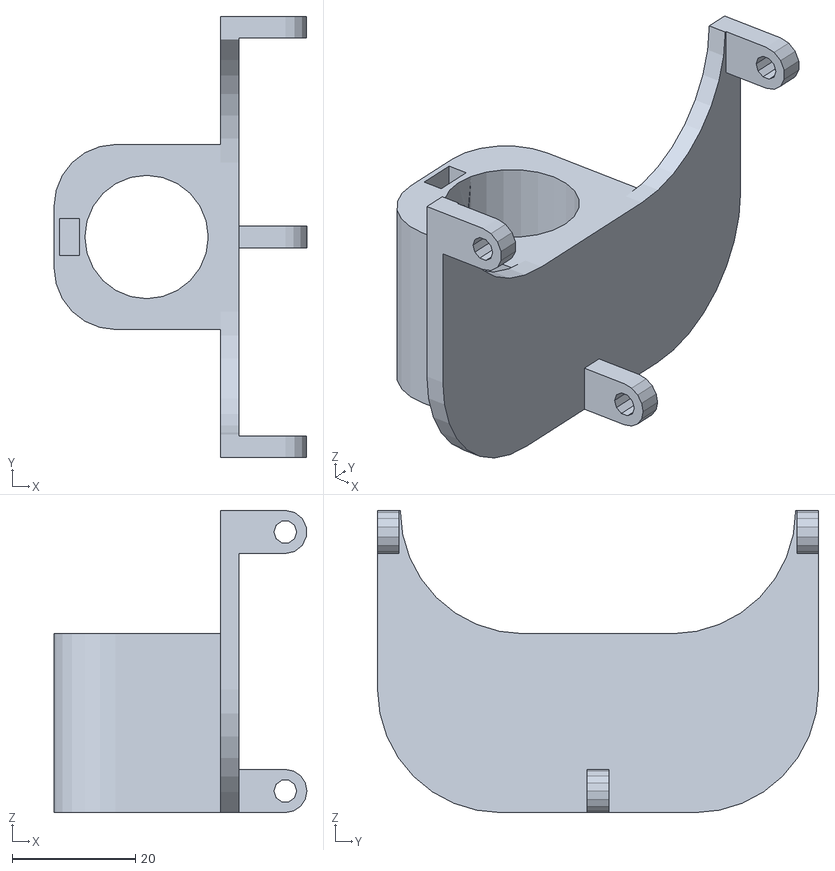
[picture p44: CAD file, 2019-03-12]
pièces 3D/Catia/porte crayon mobile.stl
41.0 x 71.5 x 49.0
