tbourgoi/Projet-PeiP-2/pièces 3D/Catia/anciennes pièces/plaque Robot.stl

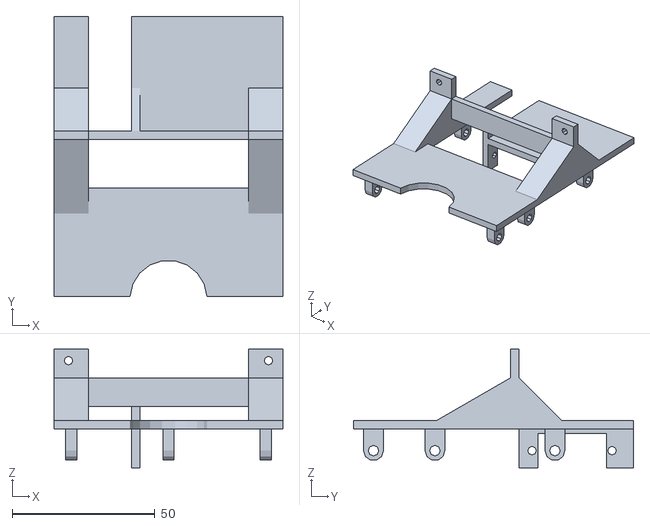
[picture p45: CAD file, 2019-02-09]
pièces 3D/Catia/anciennes pièces/plaque Robot.stl
80.0 x 98.0 x 41.5
