tbourgoi/Projet-PeiP-2/pièces 3D/Catia/biele moteur_25mm.stl

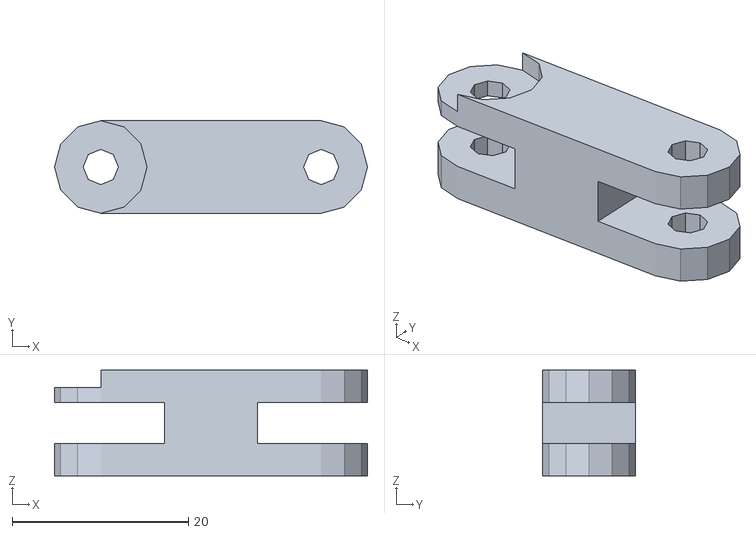
[picture p46: CAD file, 2019-02-08]
pièces 3D/Catia/biele moteur_25mm.stl
35.5 x 10.5 x 12.0
