tbourgoi/Projet-PeiP-2/pièces 3D/Catia/anciennes pièces/biele.stl

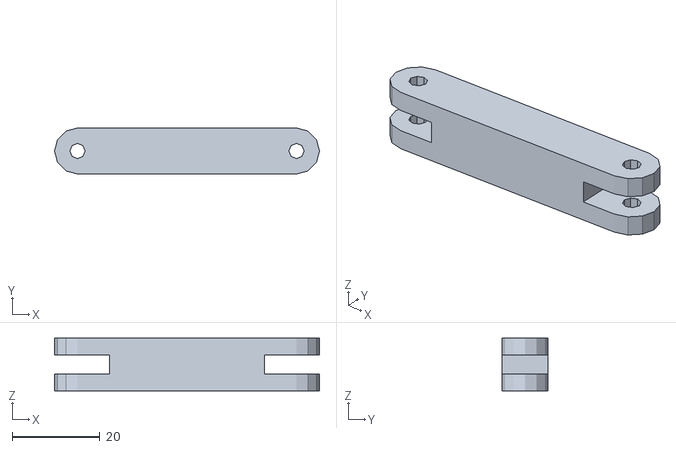
[picture p47: CAD file, 2019-02-01]
pièces 3D/Catia/anciennes pièces/biele.stl
60.5 x 10.5 x 12.0
