tbourgoi/Projet-PeiP-2/pièces 3D/Catia/anciennes pièces/plaque prototype porte crayon.stl

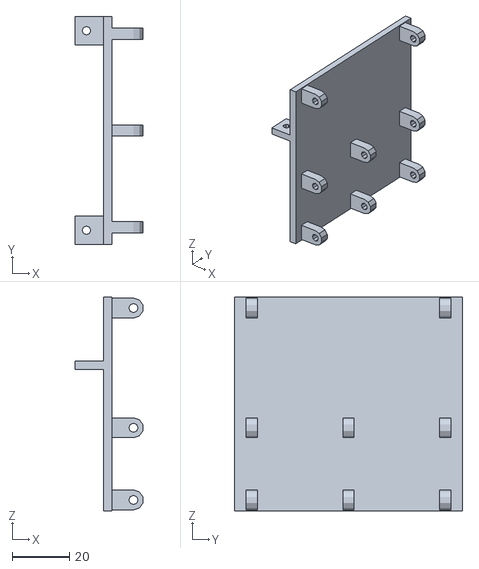
[picture p49: CAD file, 2019-01-25]
pièces 3D/Catia/anciennes pièces/plaque prototype porte crayon.stl
23.8 x 80.0 x 75.0
