tbourgoi/Projet-PeiP-2/pièces 3D/Catia/anciennes pièces/porte_pile.stl

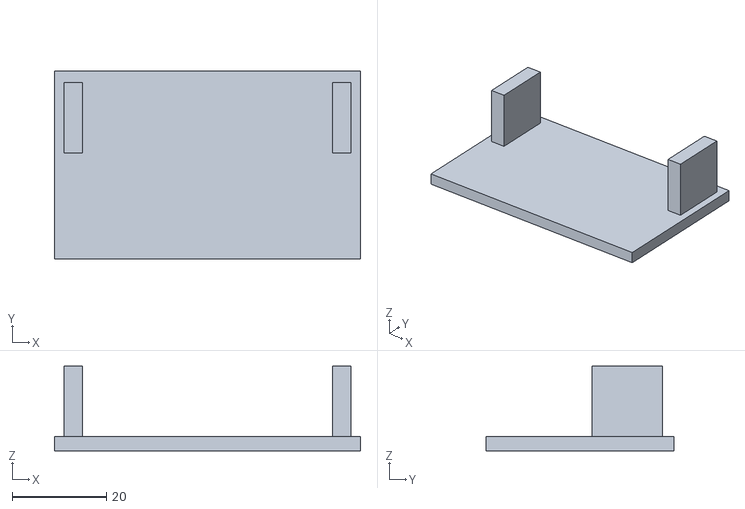
[picture p50: CAD file, 2019-01-20]
pièces 3D/Catia/anciennes pièces/porte_pile.stl
65.0 x 40.0 x 18.0
