tbourgoi/Projet-PeiP-2/(list of files, cad)

Other CAD files:
pièces 3D/Catia/anciennes pièces/plaque Robot allege.stl
pièces 3D/Catia/anciennes pièces/biele moteur.stl
pièces 3D/Catia/Asemblage1.1.CATProduct
pièces 3D/Catia/anciennes pièces/Assemblage.CATProduct
pièces 3D/Catia/anciennes pièces/biele moteur.CATPart
pièces 3D/Catia/anciennes pièces/biele.CATPart
pièces 3D/Catia/anciennes pièces/plaque Robot allege.CATPart
pièces 3D/Catia/anciennes pièces/plaque Robot.CATPart
pièces 3D/Catia/anciennes pièces/plaque porte crayon V2.CATPart
pièces 3D/Catia/anciennes pièces/plaque prototype porte crayon.CATPart
pièces 3D/Catia/anciennes pièces/porte crayon.CATPart
pièces 3D/Catia/anciennes pièces/porte_pile.CATPart
pièces 3D/Catia/bras moteur_25mm.CATPart
pièces 3D/Catia/bras_25mm.CATPart
pièces 3D/Catia/plaque côté Robot.CATPart
pièces 3D/Catia/porte crayon mobile.CATPart
pièces 3D/Catia/test crémaillère/engrenage.CATPart
pièces 3D/Sketch up/Coque_ancienne version.skp
pièces 3D/Sketch up/coque avec plaque dessous premiere version.skp
pièces 3D/Sketch up/essai 2.0 avec trous elargis.skp
pièces 3D/Sketch up/essai 2.0 avec trous trop petits.skp
pièces 3D/Sketch up/pièce ouverture pour capteur plus large.skp
pièces 3D/Sketch up/plan_porte_crayon_v2.skp
