tbourgoi/Projet-PeiP-2/rapport/polytechlatex-master/testRapport.tex

\documentclass{polytech}
\schooldepartment{di}
\typereport{peip2}
\reportyear{2019}

\student{thomas}{bourgoin}{thomas.bourgoin@etu.univ-tours.fr}
\academicsupervisor[di]{firstname}{lastname}{mail}
\posterblock{title}{paragraph}{polytech.png}{image legend}
\begin{document}

\end{document}
