tbourgoi/Projet-PeiP-2/rapport/polytechlatex-master/testRapport.pdf

# Projet Parcours des écoles d’ingénieurs Polytech 2

# thomas bourgoin

# Encadrement : firstname lastname

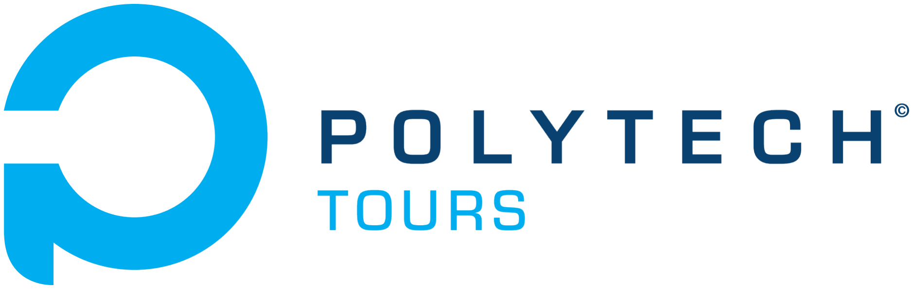
[picture p54: figure]

Ecole Polytechnique de l’Université de Tours
Département premier cycle / Parcours des écoles d’ingénieurs Polytech

### 64 avenue Jean Portalis, 37200 Tours, France

polytech.univ-tours.fr

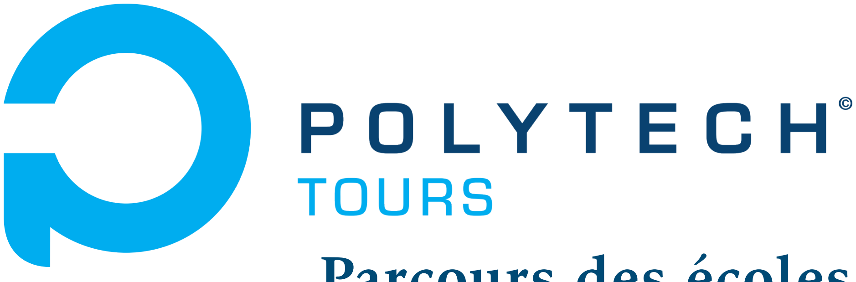
[picture p55: figure]

### Parcours des écoles d’ingénieurs Polytech

image legend

# title

## paragraph

# Projet Parcours des écoles d’ingénieurs Polytech 2

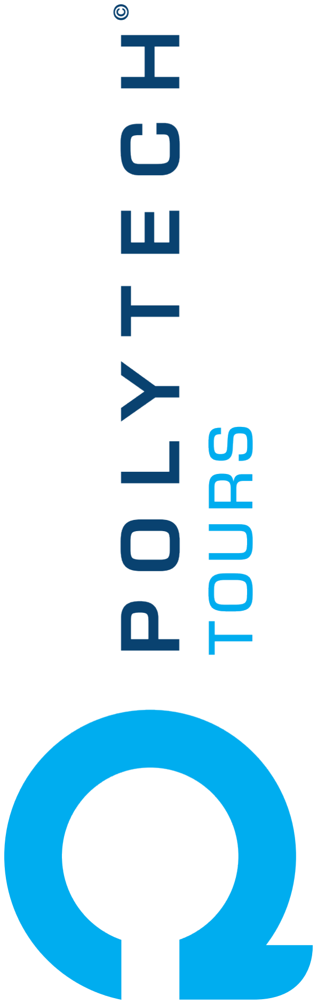
[picture p56: figure]

# thomas bourgoin

# Encadrement : firstname lastname

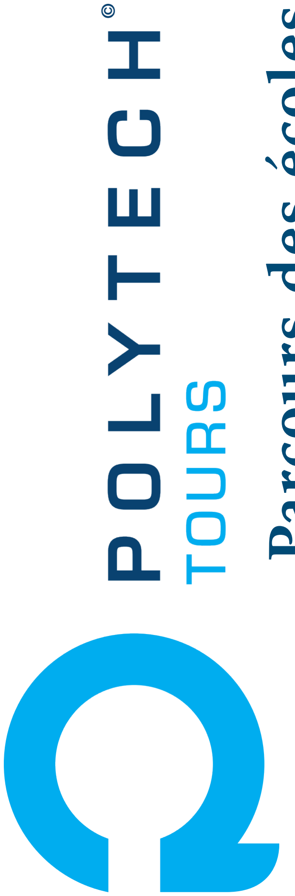
[picture p57: figure]

Ecole Polytechnique de l’Université de Tours

Département premier cycle / Parcours des écoles d’ingénieurs Polytech

### 64 avenue Jean Portalis, 37200 Tours, France

polytech.univ-tours.fr

### Parcours des écoles

### d’ingénieurs Polytech

image legend

# title

## paragraph

Résumé
Mots-clés

Abstract
Keywords
