tbourgoi/Projet-PeiP-2/programmes/programme 2018/programme_led/programme_led.ino

const int led1=13;
const int led2=12;


void setup() {
  // put your setup code here, to run once:
  pinMode(led1, OUTPUT);
  pinMode(led2, OUTPUT);
  
}

void loop() {
  // put your main code here, to run repeatedly:
  digitalWrite(led1, HIGH);
  digitalWrite(led2, LOW);
  delay(3000);
  digitalWrite(led1, LOW);
  digitalWrite(led2, HIGH);
  delay(1000);
}
