tbourgoi/Projet-PeiP-2/(commit log)

2019-01-20 organisation dossier
    déplacement fichier catia + stl dans un dossier à part
    [plaque Robot.CATPart, plaque Robot.stl, porte crayon.CATPart, porte_pile.CATPart, porte_pile.stl]
2019-01-20 DossierRoboticsBOEShield
    ajout du dossier de Gdrive
2019-01-20 Programmes2018
    Ajout du dossier de Gdrive
2019-01-24 test update
    [porte_pile.CATPart]
2019-01-25 plaque robot terminé
    pièce catia terminé
    [plaque Robot.CATPart]
2019-01-25 pièce 3D
    ajout de la bièle et mise à jour de la plaque robot
    [biele.CATPart, plaque Robot.CATPart]
2019-01-25 plaque robot terminéé
    plaque robot terminé + bielle
    [biele.CATPart, plaque Robot.CATPart, plaque Robot.stl]
2019-01-25 porte crayon 3D terminé
    [plaque prototype porte crayon crayon.CATPart]
2019-01-25 pièce 3D up date
    [biele.CATPart, plaque Robot.CATPart, plaque prototype porte crayon.stl]
2019-01-26 pièces 3D terminé
    bille spécifique pour le moteur créer
    et debut du projet secret
    [base.SLDPRT, biele moteur.CATPart, pile.SLDPRT, plaque prototype porte crayon.CATPart]
2019-02-01 pièce 3D stl
    ajout des fichier stl des pièces 3D
    [Assemblage.CATProduct, Assemblage.stp, biele moteur.CATPart, biele moteur.stl, biele.CATPart, biele.stl, plaque Robot.stl]
2019-02-01 ajout espacement
    mise à jour des bielle avec 0.3 mm de jeu pour la mobilité
    [biele moteur.CATPart, biele moteur.stl, biele.CATPart, biele.stl]
2019-02-08 nouvelles bielles
    nouvelles bielles + agrandissement de l'espacement
    [biele moteur_25mm.CATPart, biele moteur_25mm.stl, biele_25mm.CATPart, biele_25mm.stl]
2019-02-09 réalignement des accroches de la plaque du robot
    [plaque Robot.CATPart, plaque Robot.stl]
2019-02-15 Update gestion_moteur_pasApas.ino
    mise à jour des boucles pour levé et début implémentation du bouton
2019-02-18 Update plaque Robot.CATPart
    repositionnement des accroches proprement ( indépendant de l'axe moteur)
    [plaque Robot.CATPart]
2019-02-18 nouvelles pièces côté robot
    modification de la pièce prototype côté robot une version arrondi et une version avec des lignes droites
    [plaque Robot allege.CATPart, plaque Robot allege.stl, plaque Robot arrondi.CATPart, plaque Robot arrondi.stl, plaque Robot.CATPart]
2019-02-18 Update plaque Robot arrondi.CATPart
    [plaque Robot arrondi.CATPart]
2019-02-19 Assemblage1.1 du prototype
    version 1.1 du système avec bièle plus petite et plaque robot modifiée
    [Asemblage1.1.CATProduct, Asemblage1.1.stp, biele moteur_25mm.CATPart, biele_25mm.CATPart, plaque Robot.CATPart, plaque prototype porte crayon.CATPart]
2019-03-01 mise à jour gestion gestion moteur + pièces V2
    [plaque Robot arrondi.CATPart, plaque Robot arrondi.stl, plaque Robot.CATPart, plaque porte crayon V2.CATPart]
2019-03-01 porte crayon V2 à jour
    [plaque Robot arrondi.CATPart, plaque porte crayon V2.CATPart, plaque porte crayon V2.stl, porte crayon.CATPart]
2019-03-12 plein de truc
    rangment des pièces 3D
    mise à jour programme
    ...
    [Asemblage1.1.stp, Assemblage.CATProduct, Assemblage.stp, biele moteur.CATPart, biele moteur.stl, biele.CATPart, biele.stl, plaque Robot allege.CATPart]
2019-04-06 fin du projet
    [biele moteur_25mm.CATPart, biele_25mm.CATPart, bras moteur_25mm.CATPart, bras_25mm.CATPart, plaque Robot arrondi.CATPart, plaque Robot arrondi.stl, plaque Robot.CATPart, plaque Robot.stl]
2019-05-10 Fin du projet
    Le projet est fini version finale du mécanisme
    [base.SLDPRT, pile.SLDPRT, plaque côté Robot.CATPart, plaque côté Robot.stl, plaque porte crayon V2.CATPart, plaque porte crayon V2.stl, porte crayon mobile.CATPart, porte crayon mobile.stl]
